CortexFirmware/diypod/bitmaps.h

// ╔══════════════════════════════════════════════════════════════╗
// ║                      bitmaps.h                               ║
// ║  All PROGMEM bitmap assets. Borders, icons, hint glyphs,     ║
// ║  and the boot screen. Never modify hex data directly —       ║
// ║  regenerate from source images using an image converter.     ║
// ╚══════════════════════════════════════════════════════════════╝

#pragma once

// ── Layout Reference ─────────────────────────────────────────────
//   Header  (y=0..12):  Border6 (109x13) at x=0 + IconBatteryFrame (18x13) at x=110
//   Content (y=14..63): Border3 (109x50) at x=0  — most screens
//                       Border4 (96x50)  at x=0  — menu, tracks (paired with scrollbar)
//                       Border5 (12x50)  at x=97 — scrollbar
//   Side    (y=14..63): Border2 (18x50)  at x=110
//   Hints draw inside Border2 interior (x=112..123)

// ── Boot Screen ───────────────────────────────────────────────────

// bmp_Boot1: splash screen shown during startup, 128x64
const uint8_t bmp_Boot1[] PROGMEM = {
	0x00, 0x00, 0x00, 0x00, 0x00, 0x00, 0x00, 0x00, 0x00, 0x00, 0x00, 0x00, 0x00, 0x00, 0x00, 0x00, 
	0x00, 0x00, 0x00, 0x00, 0x00, 0x00, 0x00, 0x00, 0x00, 0x00, 0x00, 0x00, 0x00, 0x00, 0x00, 0x00, 
	0x00, 0x00, 0x00, 0x00, 0x00, 0x00, 0x00, 0x00, 0x00, 0x00, 0x00, 0x00, 0x00, 0x00, 0x00, 0x00, 
	0x00, 0x00, 0x00, 0x00, 0x00, 0x00, 0x00, 0x00, 0x00, 0x00, 0x00, 0x00, 0x00, 0x00, 0x00, 0x00, 
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
  0x7f,0xe0, 0xff,0xf0, 0xff,0xf0, 0xff,0xf0, 0xff,0xf0, 0xc0,0x30,
  0xc0,0x30, 0xff,0xf0, 0xff,0xf0, 0xff,0xf0, 0xff,0xf0, 0x7f,0xe0
};

// bmp_HintNull: empty/no-action placeholder, 8x8
const uint8_t bmp_HintNull[] PROGMEM = {
	0x3c, 0x7e, 0xff, 0xff, 0xff, 0xff, 0x7e, 0x3c
};
